suryanshchandra/Elvis/README.md

Elvis
=====

6-axis Robotic Arm made of laser cut parts, driven directly from Rhino & Grasshopper.

If you're interested in building Elvis, please go through the hardware folder and read through the Elvis1.0_HardwareReadme.txt.
