suryanshchandra/Elvis/Hardware/Elvis1.0_LaserCut.png

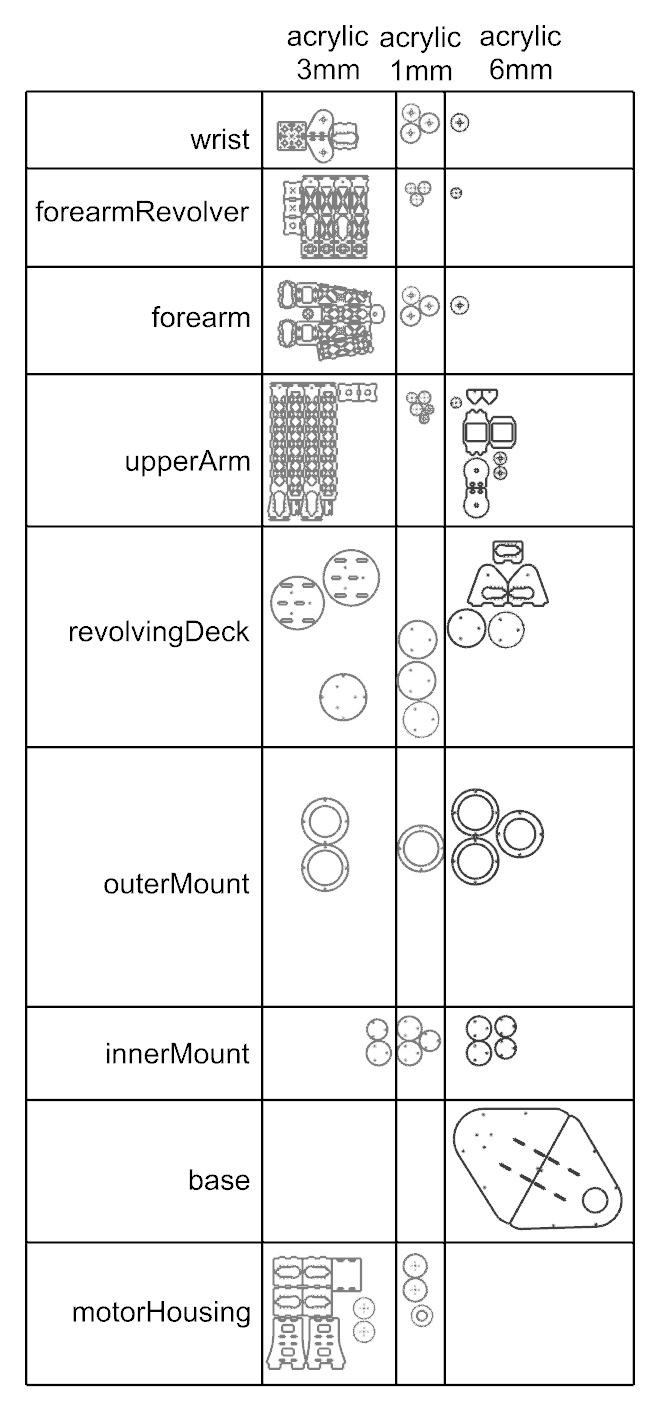
Hardware/Elvis1.0_LaserCut.png
