suryanshchandra/Elvis/Hardware/Elvis1.0_Range_2d.png

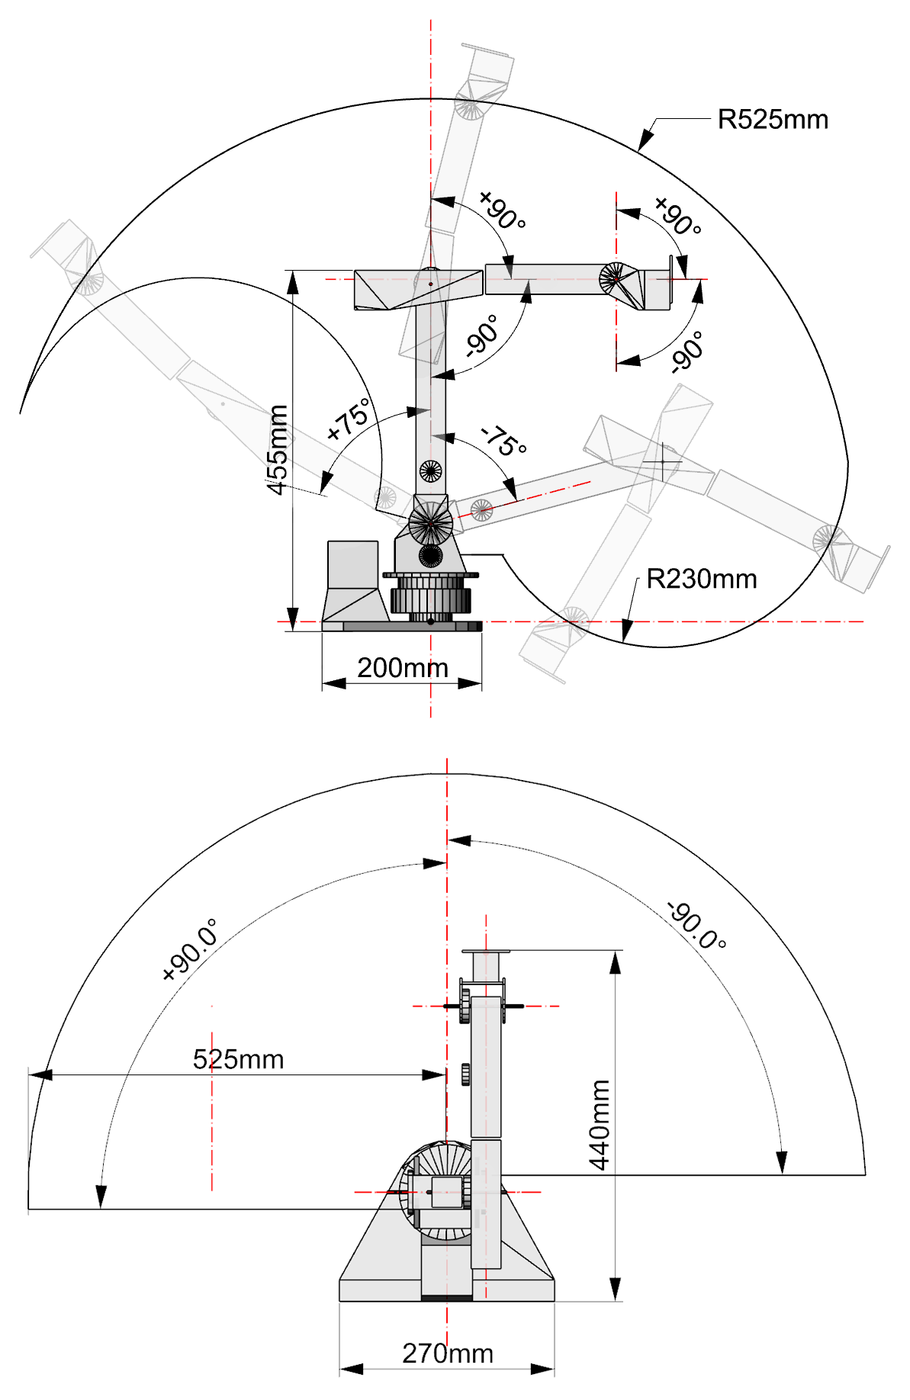
Hardware/Elvis1.0_Range_2d.png
