suryanshchandra/Elvis/Hardware/Elvis1.0_Range_3d.png

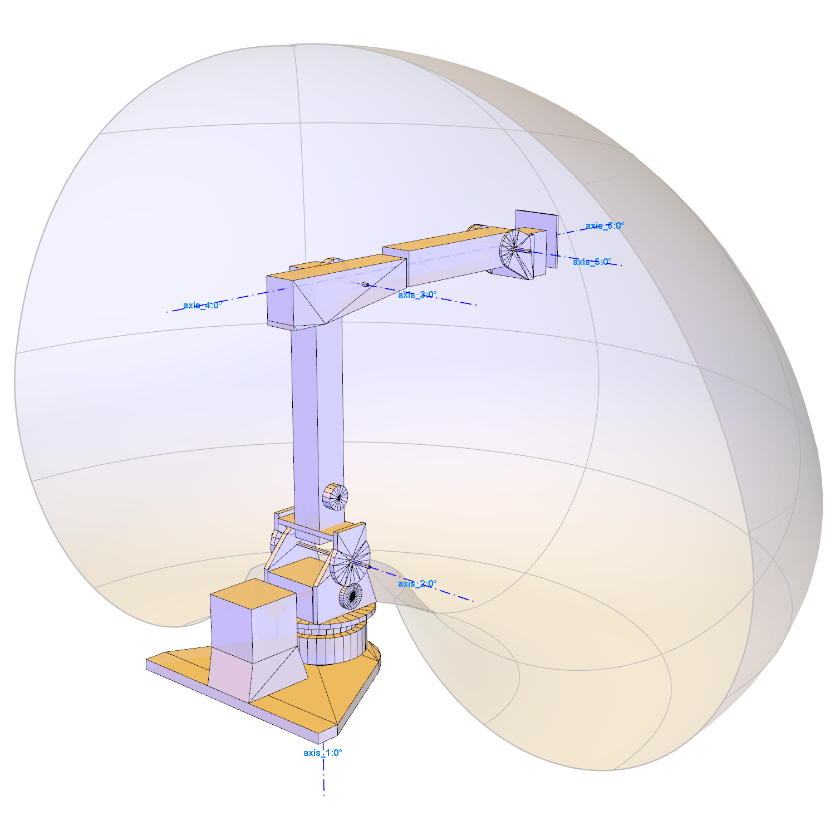
Hardware/Elvis1.0_Range_3d.png
