suryanshchandra/Elvis/Hardware/BillOfMaterials.xlsx

Category | Component | Qty | Price | Amount | Source in UK
Electronics | Dynamixel AX-12A | 8 | £32.30 | £258.40 | http://robosavvy.com/store/product_info.php/products_id/1435
Electronics | USB2Dynamixel | 1 | £35.00 | £35.00 | http://robosavvy.com/store/product_info.php/products_id/222
Electronics | SMPS2Dynamixel | 1 | £4.80 | £4.80 | http://robosavvy.com/store/product_info.php/products_id/505
Electronics | Dynamixel Extension Leads (Pack of 10) | 1 | £10.90 | £10.90 | http://robosavvy.com/store/product_info.php/cPath/35/products_id/3459
Electronics | Jumper Wires (Short, Pack of 140) | 1 | £5.33 | £5.33 | http://robosavvy.com/store/product_info.php/products_id/1178
Electronics | Jumper Wires (Long, Pack of 10) | 2 | £3.37 | £6.74 | http://proto-pic.co.uk/jumper-wires-premium-12-m-m-pack-of-10/
Electronics | USB Extension Cable | 1 | £3.63 | £3.63 | http://www.amazon.co.uk/dp/B0000DG4WP/ref=pe_385721_37986871_TE_item
Electronics | 12V 5A Power Supply | 1 | £9.99 | £9.99 | http://www.amazon.co.uk/dp/B00CQEI2IU/ref=pe_385721_37986871_TE_item
Hardware | Timing Belt, MXL 280T | 1 | £4.62 | £4.62 | http://www.motionco.co.uk/rubber-timing-belt-p-237.html
Hardware | Timing Belt, MXL 133T | 1 | £3.02 | £3.02 | http://www.motionco.co.uk/rubber-timing-belt-p-369.html
Hardware | Timing Belt, MXL 180T | 1 | £3.69 | £3.69 | http://www.motionco.co.uk/rubber-timing-belt-p-187.html
Hardware | Metal Shaft 4mmx150mm | 1 | £2.62 | £2.62 | http://www.technobotsonline.com/metal-shaft-4x150mm-pk-1.html
Hardware | Pololu Mounting Hub 4mm + 4-40 US Mounting, Pack of 2 | 1 | £5.66 | £5.66 | http://www.technobotsonline.com/pololu-mounting-hub-4mm--4-40-us-mounting.html
Hardware | Miniature Flange Bearings MF84ZZ (4x8x3) | 12 | £0.89 | £10.68 | http://www.technobotsonline.com/miniature-flange-bearing-mf84zz-4x8x3.html
Hardware | Deep Groove Ball Bearing 45x75x16mm (6009) | 1 | £8.22 | £8.22 | http://simplybearings.co.uk/shop/p170199/6009ZZ+Budget+Metal+Shielded+Deep+Groove+Ball+Bearing+45x75x16mm/product_info.html
Fixings | Spring (Split) Washer M4, Pack of 100 | 1 | £0.97 | £0.97 | http://www.technobotsonline.com/spring-split-washer-m4-pack-of-100.html
Fixings | Threaded rod M4 x 100mm | 2 | £0.44 | £0.88 | http://www.technobotsonline.com/threaded-rod-m4-x-100mm.html
Fixings | Threaded rod M4 x 150mm | 1 | £0.54 | £0.54 | http://www.technobotsonline.com/threaded-rod-m4-x-150mm-33100.html
Fixings | American 4-40 1/4" Long Pan Head Screw pk/25 | 1 | £0.82 | £0.82 | http://www.technobotsonline.com/american-4-40-1-4-long-pan-head-screw-pk-25.html
Fixings | American 4-40 Hex Plain Nut pk/25 | 1 | £0.59 | £0.59 | http://www.technobotsonline.com/american-4-40-hex-plain-nut-pk-25.html
Fixings | American 4-40 1/2" Long Pan Head Screw pk/25 | 1 | £1.06 | £1.06 | http://www.technobotsonline.com/american-4-40-1-2-long-pan-head-screw-pk-25.html
Fixings | CSK Head M4 x 16 (per 100) | 1 | £2.66 | £2.66 | http://www.technobotsonline.com/csk-head-m4-x-16-per-100.html
Fixings | Pan Head M2 x 12 (Pk of 100) | 1 | £2.02 | £2.02 | http://www.technobotsonline.com/pan-head-m2-x-12-pk-of-100.html
Fixings | Pan Head M4 x 16 (per 100g) | 1 | £0.95 | £0.95 | http://www.technobotsonline.com/pan-head-m4-x-16-per-100g.html
Fixings | Pan Head M2 x 8 (Pk of 100) | 1 | £2.20 | £2.20 | http://www.technobotsonline.com/pan-head-m2-x-8-pk-of-100.html
Fixings | Pan Head M4 x 10 per 100g | 1 | £1.45 | £1.45 | http://www.technobotsonline.com/pan-head-m4-x-10-per-100g-33000.html
Fixings | Washer M2 (Pk of 100) | 1 | £1.01 | £1.01 | http://www.technobotsonline.com/washer-bzp-m2-pk-of-100.html
Fixings | Nut M2 Stainless Steel (Pack of 100) | 1 | £2.54 | £2.54 | http://www.technobotsonline.com/nut-m2-stainless-steel-pack-of-100.html
Fixings | Flange Head M4 x 30 (Pack of 50) | 1 | £2.44 | £2.44 | http://www.technobotsonline.com/flange-head-pozi-machine-screws-m4-x-30-pk-of-50.html
Fixings | Nut M4 (pack of 100) | 1 | £1.08 | £1.08 | Misc hardware shop
Fixings | Pan Head M4 x 40 | 5 | £0.07 | £0.35 | Misc hardware shop
Fixings | Pan Head M4 x 50 | 5 | £0.11 | £0.55 | Misc hardware shop
Fixings | CSK Head M4 x 40 | 5 | £0.12 | £0.60 | Misc hardware shop
Fixings | CSK Head M4 x 50 | 5 | £0.08 | £0.40 | Misc hardware shop
SheetMaterial | Acrylic, 6mm thk | 1 | £30.00 | £30.00 | -
SheetMaterial | Acrylic, 1mm thk | 1 | £20.00 | £20.00 | -
SheetMaterial | Acrylic, 3mm thk | 1 | £15.00 | £15.00 | -
Misc | Plastic Weld Solvent | 1 | £10.00 | £10.00 | -
 | Total |  |  | £471.41
