suryanshchandra/Elvis/(list of files, cad)

Other CAD files:
Hardware/Elvis1.0_LaserCut2d.3dm
Software/Elvis_MissionControl_1.0.3dm
