suryanshchandra/Elvis/Hardware/Elvis1.0_Assembly3d.png

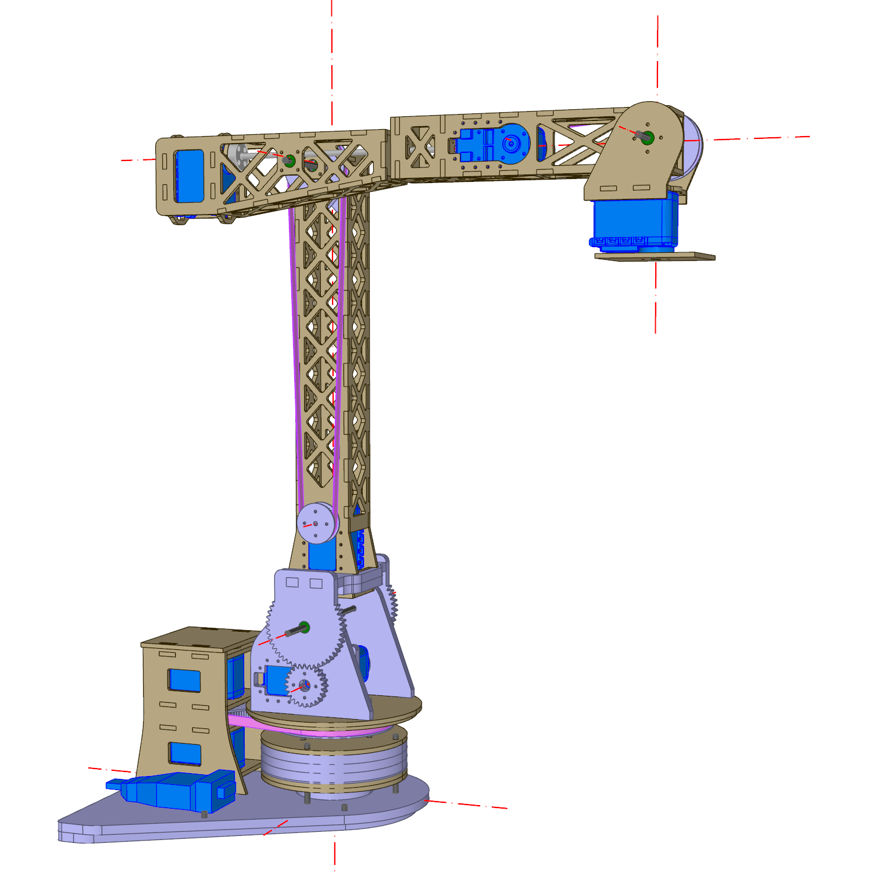
Hardware/Elvis1.0_Assembly3d.png
