suryanshchandra/Elvis/(commit log)

2014-09-11 missionControl Uploaded
    [BillOfMaterials.xlsx, Elvis_MissionControl_1.0.3dm]
2014-09-21 MinorUpdate
    Resolves the issue of using custom GH plugins
    [Elvis_MissionControl_1.0.3dm]
